Beelzemon97/AI-SED-PCB/docs/pcb_bottom.png

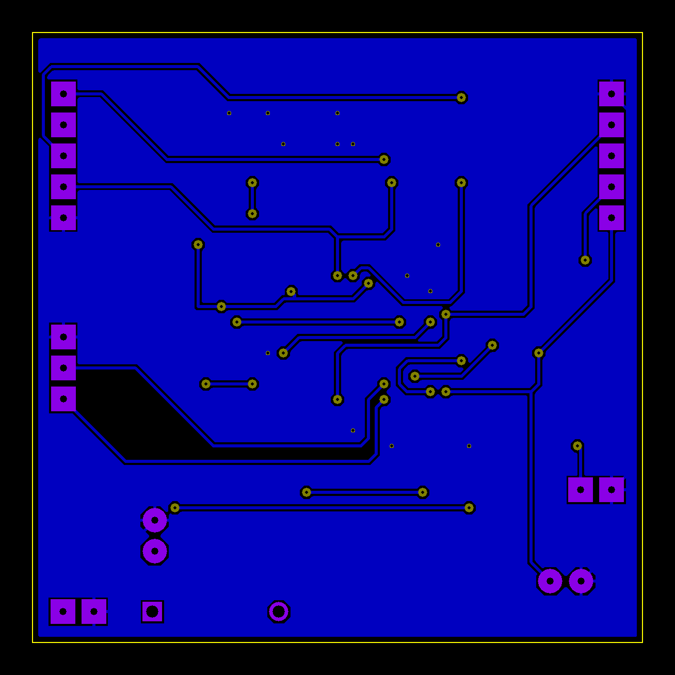
docs/pcb_bottom.png
