Beelzemon97/AI-SED-PCB/docs/placa_ruteada.png

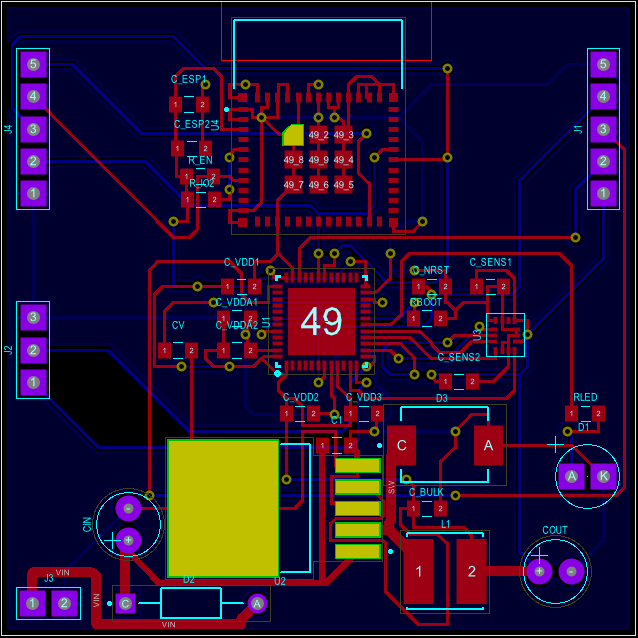
docs/placa_ruteada.png
