Beelzemon97/AI-SED-PCB/hardware/proteus/sim-demo-terminal.png

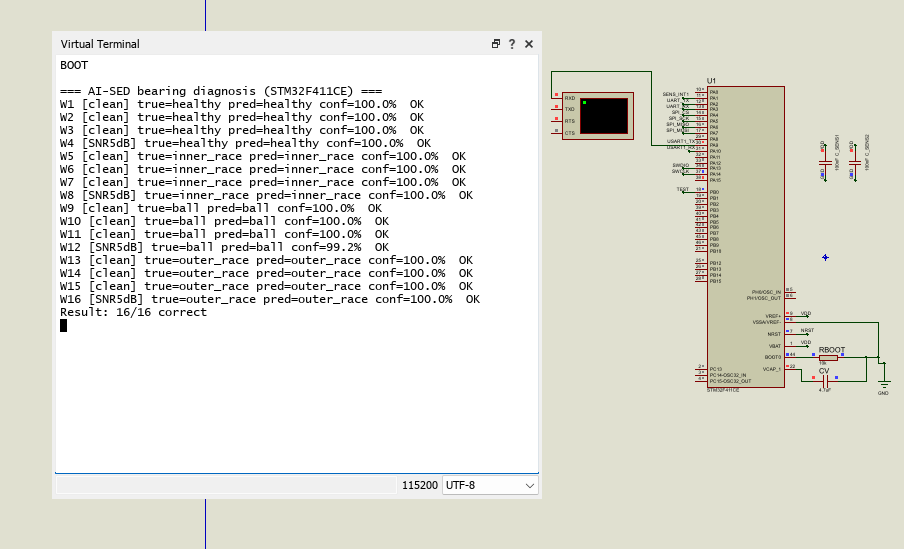
hardware/proteus/sim-demo-terminal.png
