Beelzemon97/AI-SED-PCB/model/matriz_confusion_corregida.png

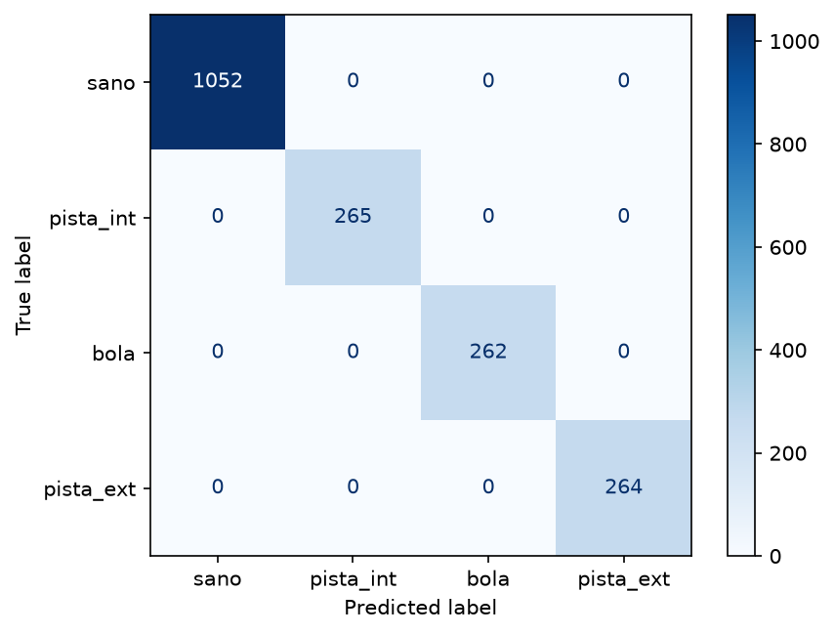
model/matriz_confusion_corregida.png
