Beelzemon97/AI-SED-PCB/hardware/bom/README.MD

# Bill of materials

`BOM_AI-SED-PCB.csv`: 31 parts in 19 lines (main ICs, power stage, diodes, LED, capacitors, resistors, connectors).

Main parts: STM32F411CE, IIS3DWB, LM2596S-3.3, ESP32-C3-MINI-1-N4, SRN6045TA330M (33 µH), 1N5819H, SS34.

Passives and connectors are marked "to be selected": exact manufacturer part numbers must be chosen with the fabricator before ordering.

Cost estimate: see Section 6 of the competition document in `docs/`.
