Beelzemon97/AI-SED-PCB/firmware/include/modelo_pesos.h

// MLP 22-32-16-4, float32. fs=13333.33 Hz, ventana 1024
static const float MEAN[22]={2.25127356e-01f,9.56175687e-01f,3.68189206e+00f,9.14542375e-01f,-4.38359155e-02f,2.25127356e-01f,-3.72010085e+00f,-3.81616137e+00f,-3.53731057e+00f,-4.12433682e+00f,-4.46687113e+00f,-3.80708790e+00f,-4.13423111e+00f,-4.17975420e+00f,-4.08597016e+00f,-4.81631983e+00f,-5.00889837e+00f,-5.00365352e+00f,-5.12626489e+00f,-5.75394918e+00f,-6.80595300e+00f,-6.23988096e+00f};
static const float SCALE[22]={2.52613274e-01f,1.22353224e+00f,7.28147931e-01f,1.67078479e+00f,1.34403432e-01f,2.52613274e-01f,4.95108415e-01f,5.75437647e-01f,5.18512221e-01f,8.13631377e-01f,8.09506578e-01f,5.72435964e-01f,1.75668896e+00f,1.68202883e+00f,1.93879031e+00f,1.56587137e+00f,1.22830175e+00f,1.03373623e+00f,1.38271090e+00f,1.75475164e+00f,2.78352309e+00f,2.23733296e+00f};
static const float W1[22][32]={{-1.97816715e-01f,2.56435633e-01f,-3.52229960e-02f,-1.46177858e-01f,1.28549768e-03f,2.56969154e-01f,-1.31829664e-01f,3.58356863e-01f,2.97354877e-01f,-2.88416207e-01f,1.92301705e-01f,-1.31665707e-01f,7.23813400e-02f,4.24377918e-01f,-2.27180392e-01f,-4.81913298e-01f,-5.05143702e-01f,1.72302216e-01f,9.85074118e-02f,3.33879799e-01f,2.59759188e-01f,1.09500393e-01f,-1.39276087e-01f,-2.49408092e-02f,-1.24472693e-01f,4.91300225e-02f,-3.07397306e-01f,4.17560458e-01f,3.02345250e-02f,-2.88297296e-01f,-2.30411112e-01f,2.47802824e-01f},{-2.42260277e-01f,3.18130217e-02f,-4.20321256e-01f,-1.12308472e-01f,1.24070697e-01f,1.97625086e-01f,2.07470953e-01f,2.12075964e-01f,-1.05653338e-01f,-2.48917937e-01f,1.28940299e-01f,-4.42995489e-01f,9.67864916e-02f,2.42998064e-01f,-1.41276449e-01f,-4.23005939e-01f,-2.79615641e-01f,-1.41108841e-01f,-3.96850221e-02f,3.94457467e-02f,2.68004537e-01f,-4.09871548e-01f,-2.93022603e-01f,-4.24596578e-01f,2.20398292e-01f,-2.06722960e-01f,-9.12521407e-02f,-5.67629077e-02f,-2.02569336e-01f,-4.81643170e-01f,5.85045107e-02f,-1.79063022e-01f},{-7.83108734e-03f,-2.06808835e-01f,1.34698302e-01f,-2.28440836e-01f,3.16075653e-01f,-3.19481522e-01f,2.49474138e-01f,1.24638360e-02f,3.02199185e-01f,-6.94014877e-02f,1.31333560e-01f,-4.17638630e-01f,-2.32058272e-01f,-1.34945512e-01f,-2.07949907e-01f,-9.95315835e-02f,3.01486012e-02f,-1.11510977e-01f,-3.96051228e-01f,1.02979466e-01f,7.57919764e-03f,-2.64974445e-01f,9.80028957e-02f,-3.78999650e-01f,7.72957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
static const float B1[32]={-7.12757464e-03f,6.67356327e-03f,2.59763356e-02f,-8.49585682e-02f,-1.26997143e-01f,3.53604972e-01f,-1.61881447e-01f,1.11658886e-01f,2.34155759e-01f,1.95695654e-01f,-2.66504526e-01f,-3.10428366e-02f,9.96957300e-04f,3.28971334e-02f,7.37009197e-02f,3.09616774e-01f,2.93729365e-01f,3.79509121e-01f,-1.45757258e-01f,3.05222213e-01f,-1.10512890e-01f,5.17959952e-01f,2.55442351e-01f,5.25233865e-01f,2.39051670e-01f,-1.55276194e-01f,-3.57802063e-02f,-2.83802440e-03f,-1.22290105e-01f,8.01641718e-02f,1.67907074e-01f,8.24588388e-02f};
static const float W2[32][16]={{-9.00387242e-02f,1.87306870e-02f,-8.75111520e-02f,-1.92054987e-01f,-2.40174666e-01f,3.27821672e-01f,-5.68393134e-02f,-4.84261423e-01f,3.22067618e-01f,-5.32145143e-01f,7.48495638e-01f,3.96196723e-01f,5.52440345e-01f,8.76452588e-03f,-3.97250473e-01f,1.90269649e-01f},{4.36021090e-01f,1.39286339e-01f,1.50817424e-01f,2.03650236e-01f,-4.14288223e-01f,-5.54204047e-01f,2.41032839e-01f,8.61845687e-02f,6.72765911e-01f,8.03916082e-02f,9.31658000e-02f,3.28508504e-02f,8.01364958e-01f,-1.73572093e-01f,4.36671257e-01f,9.65336561e-02f},{5.61622977e-01f,3.28528136e-01f,1.96884409e-01f,-2.03472272e-01f,-6.83486611e-02f,-3.81392896e-01f,2.31077701e-01f,1.98853776e-01f,-7.21361712e-02f,2.08034202e-01f,2.94354349e-01f,2.70841062e-01f,-4.30136502e-01f,-3.08336467e-01f,4.64747041e-01f,2.25337893e-01f},{-1.61289886e-01f,-2.49571040e-01f,7.81364962e-02f,-2.54874647e-01f,-2.44284377e-01f,-4.41954166e-01f,3.13024819e-01f,-4.08443660e-02f,3.00329179e-01f,-4.12089378e-01f,4.77560252e-01f,4.07189697e-01f,1.81942612e-01f,-4.74710792e-01f,-3.67413253e-01f,4.47681472e-02f},{-3.13780516e-01f,4.50456776e-02f,-4.39822040e-02f,-9.40412059e-02f,2.11973816e-01f,2.73670614e-01f,4.84391183e-01f,5.35795353e-02f,1.49050921e-01f,3.34432542e-01f,1.56661049e-01f,4.14329655e-02f,-1.28697576e-02f,6.45812690e-01f,-1.34569213e-01f,-2.24450544e-01f},{-2.18237266e-01f,-7.18212277e-02f,3.34451497e-01f,4.42543849e-02f,-1.36295602e-01f,-4.88164306e-01f,2.62004465e-01f,-1.97996929e-01f,4.31050323e-0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
static const float B3[4]={-5.26076913e-01f,3.83981466e-01f,-7.35036582e-02f,5.89450561e-02f};
