Beelzemon97/AI-SED-PCB/(commit log)

2026-11-07 Diseño inicial: PCB ruteada, DRC limpio
    [AI-SED-PCB.pdsprj]
2026-11-07 Add files via upload
    Se corrigio el modelo para que encajara en el dise;o del pcb a 13.3kHz
    [modelo_pesos.h]
2026-11-08 Add files via upload
    se agregaron gerbers
    [AI-SED-PCB.pdsprj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]
2026-11-08 Add files via upload
    Se crearon los gerbers
    [AI-SED-autorouter - CADCAM Bottom Copper.GBR, AI-SED-autorouter - CADCAM Bottom Solder Resist.GBR, AI-SED-autorouter - CADCAM Drill TOP-BOT Filled and Plated.GBR, AI-SED-autorouter - CADCAM Drill TOP-BOT Plated.GBR, AI-SED-autorouter - CADCAM Profile.GBR, AI-SED-autorouter - CADCAM Top Assembly.GBR, AI-SED-autorouter - CADCAM Top Copper.GBR, AI-SED-autorouter - CADCAM Top SMT Paste.GBR]
2026-11-08 Add readme for bill of materials
    Added details about the bill of materials including main parts and cost estimate.
2026-11-08 Add README.md for BOM documentation
